pikim/bldc-hardware/design/PDF/BLDC_4-B.SilkS.pdf

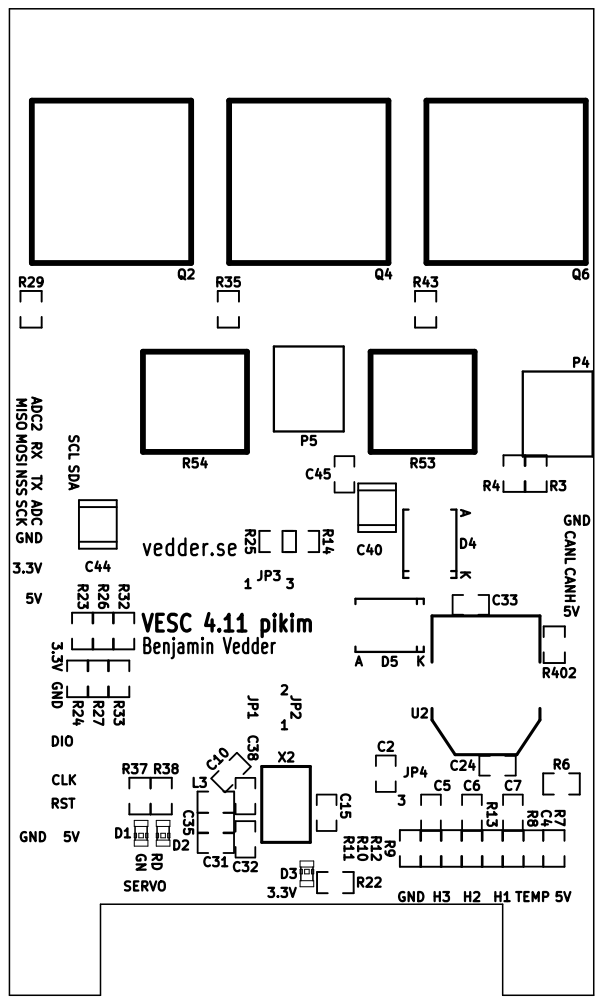
[picture p1: page 1]

5V NSS SCK MOSI MISO ADC2 SDATX SCL RX ADC vedder.seGND

5VCANH CANL GND H3 H2 H1 TEMP 5V GND GND Benjamin Vedder VESC 4.11 pikim

5V RST DIO GND CLK 3.3V
