pikim/bldc-hardware/design/PDF/BLDC_4.pdf

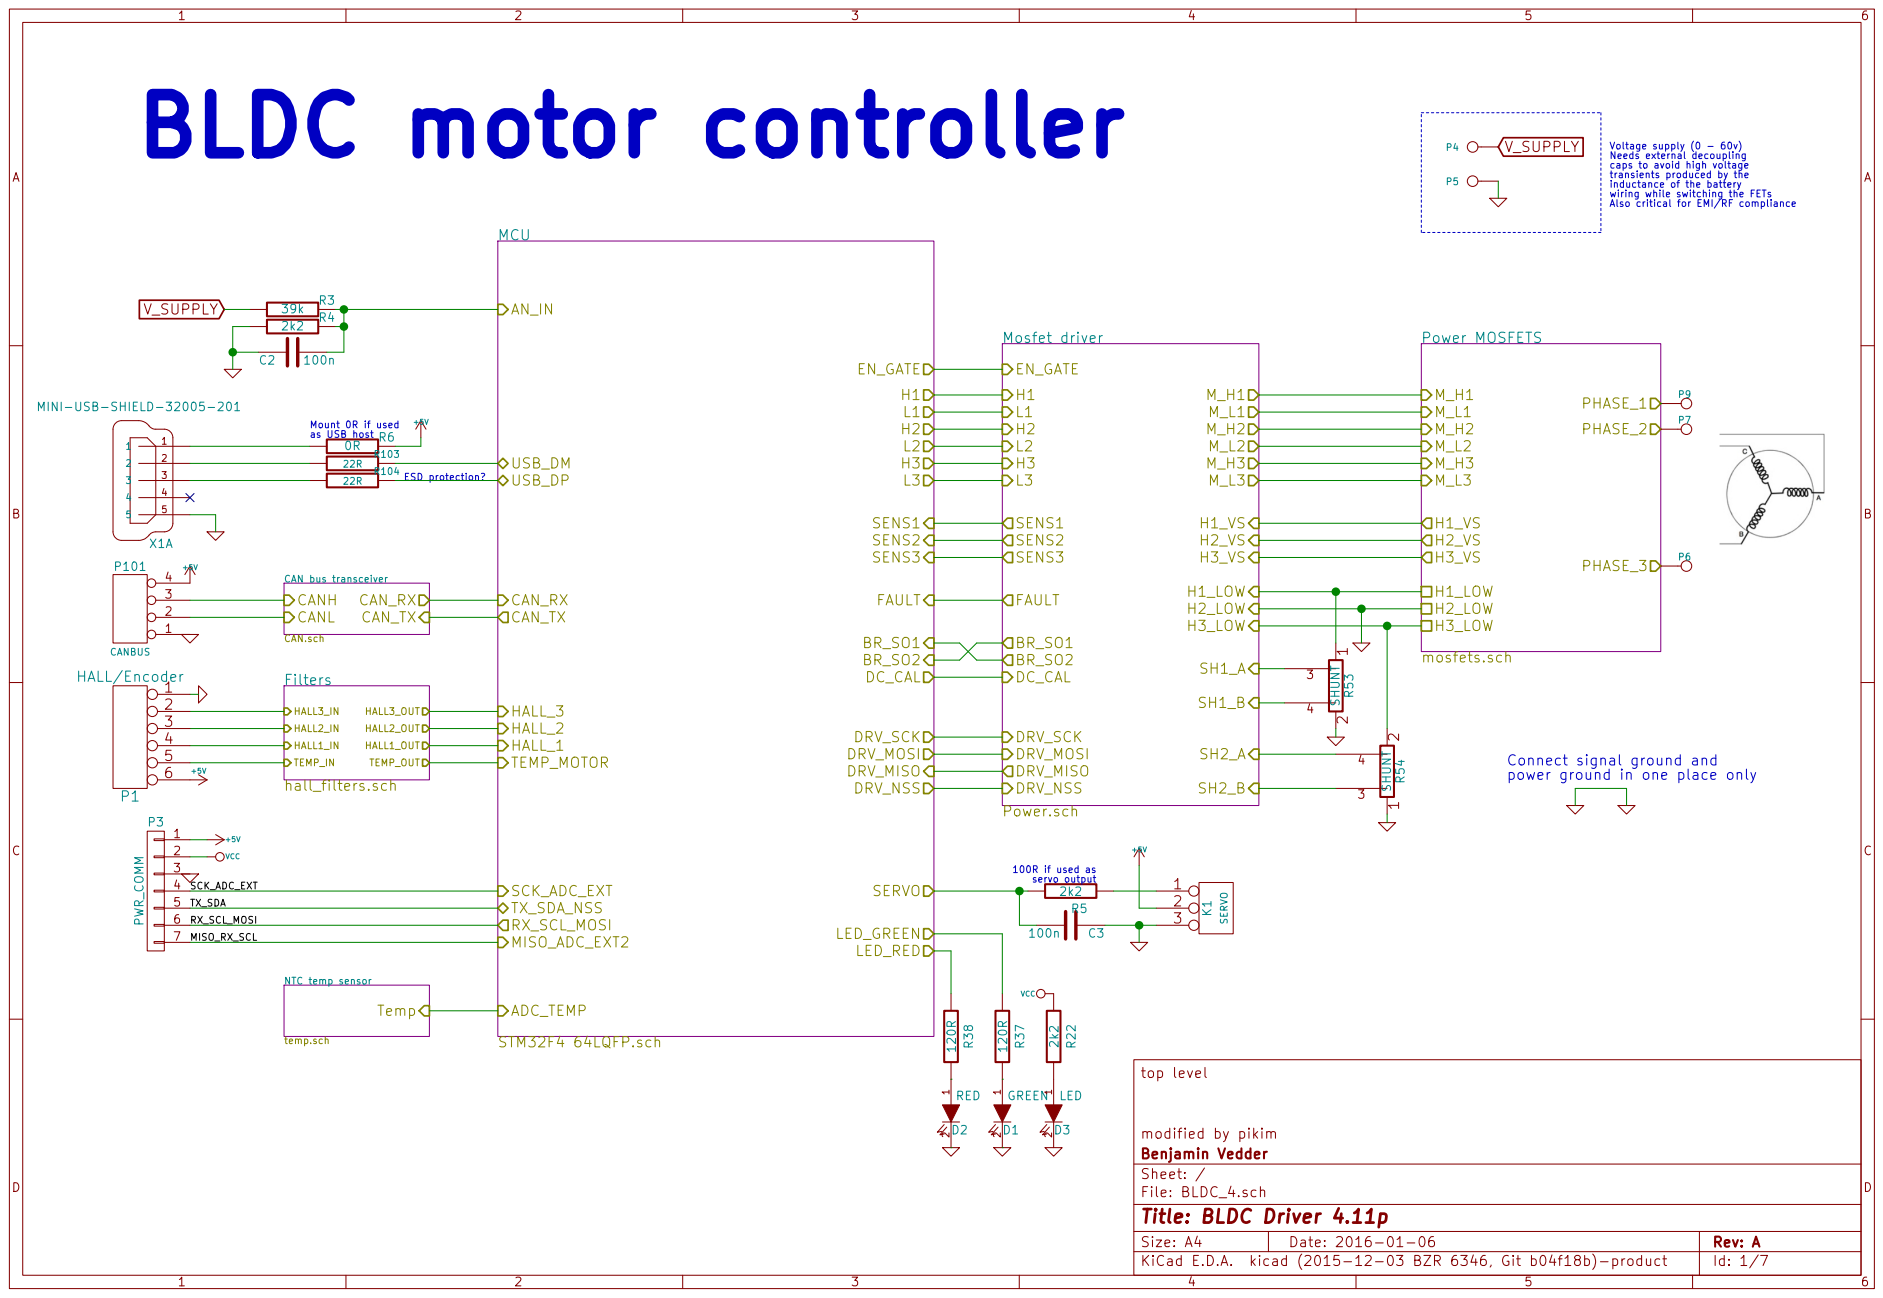
[picture p2: page 1]

Voltage supply (0 - 60v) Needs external decoupling
caps to avoid high voltage
transients produced by the

Connect signal ground and

modified by pikim
File: BLDC_4.sch Sheet: / Benjamin Vedder

Id: 1/7 Title: BLDC Driver 4.11p

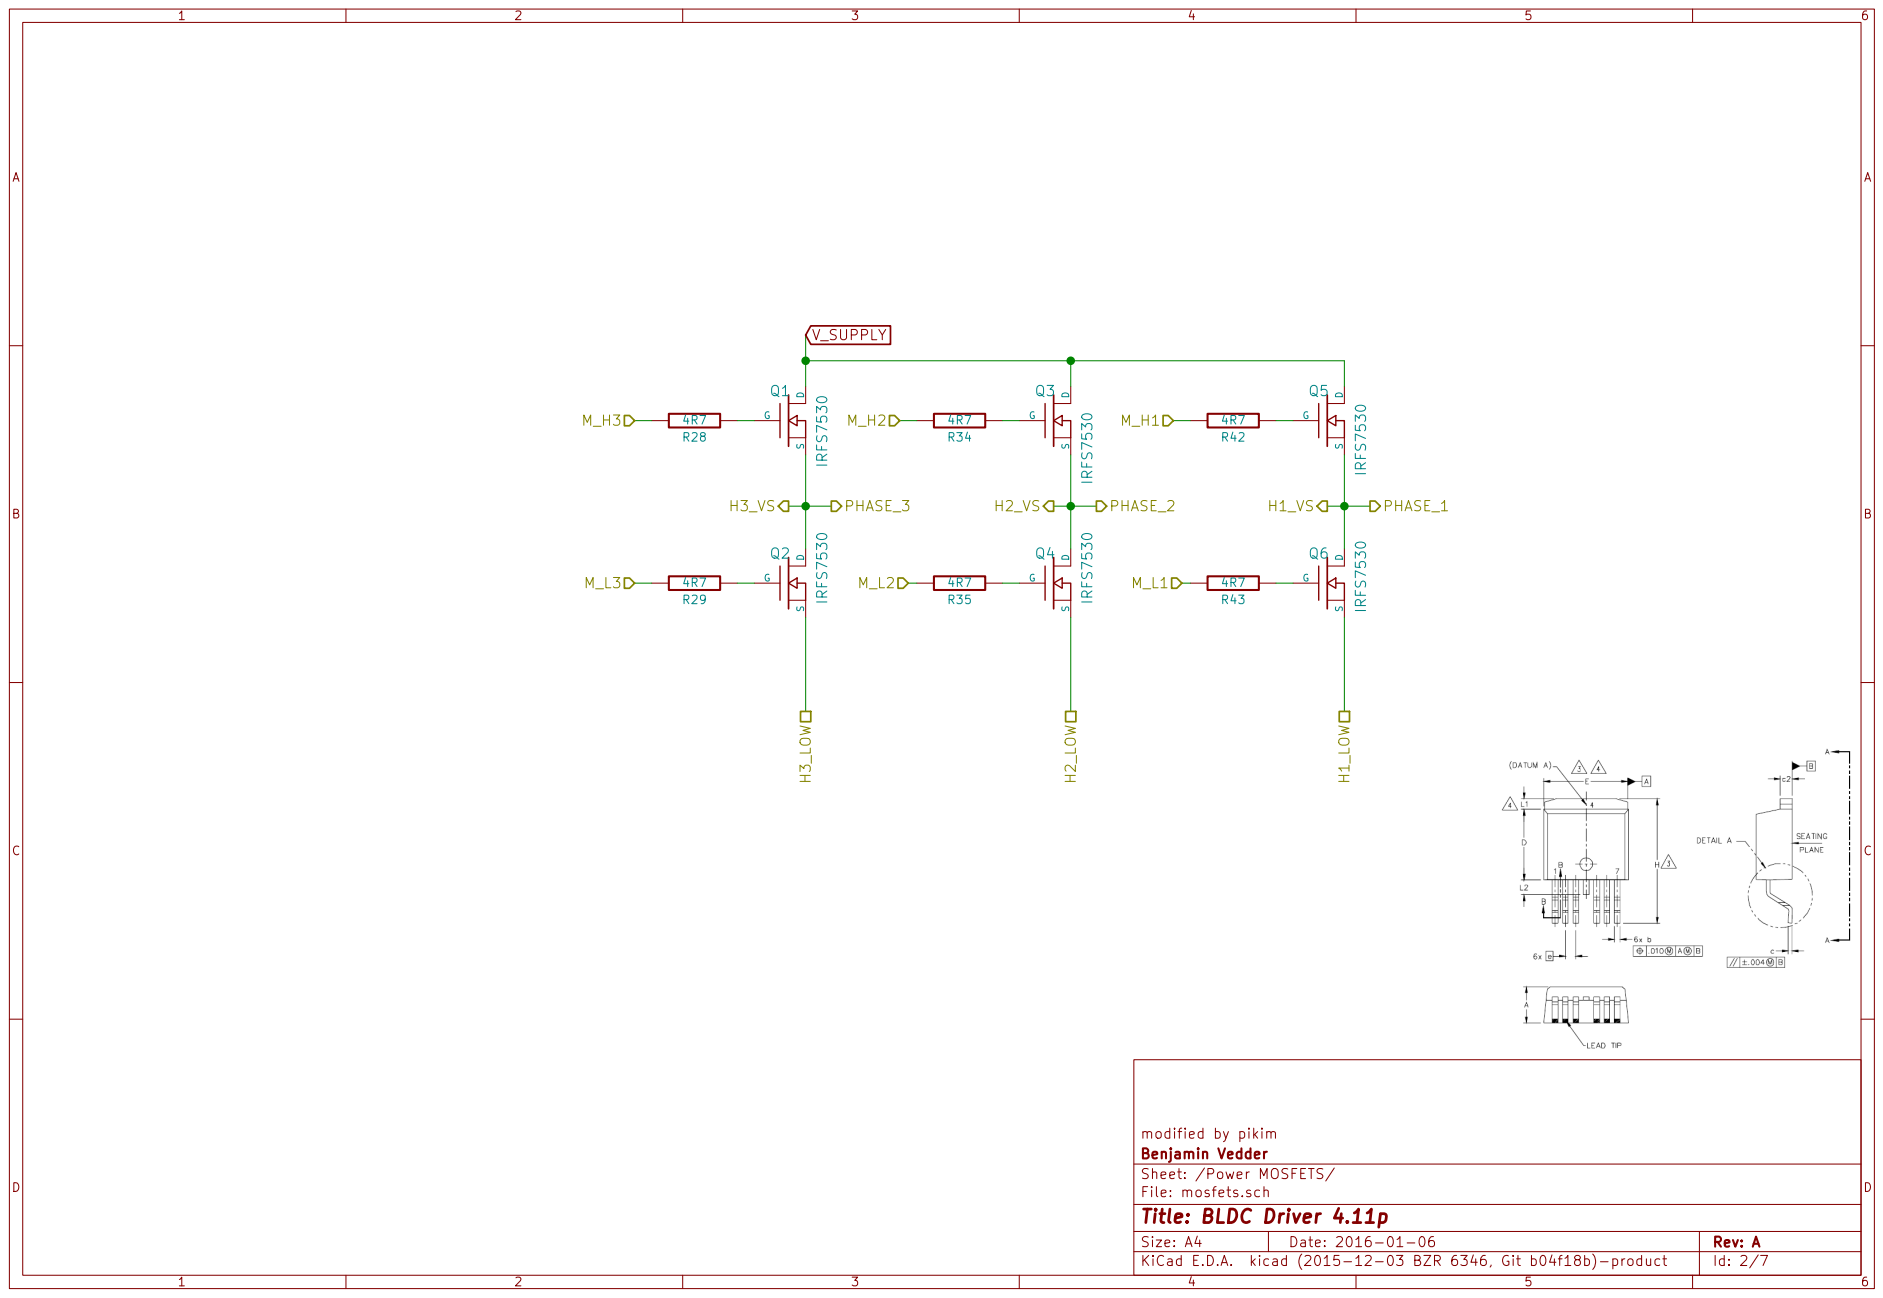
[picture p3: page 2]

modified by pikim
File: mosfets.sch Sheet: /Power MOSFETS/ Benjamin Vedder

Id: 2/7 Title: BLDC Driver 4.11p


modified by pikim R1 NTC 10k 10k R2 C41

Benjamin Vedder
Sheet: /NTC temp sensor/
File: temp.sch
Id: 3/7 Title: BLDC Driver 4.11p

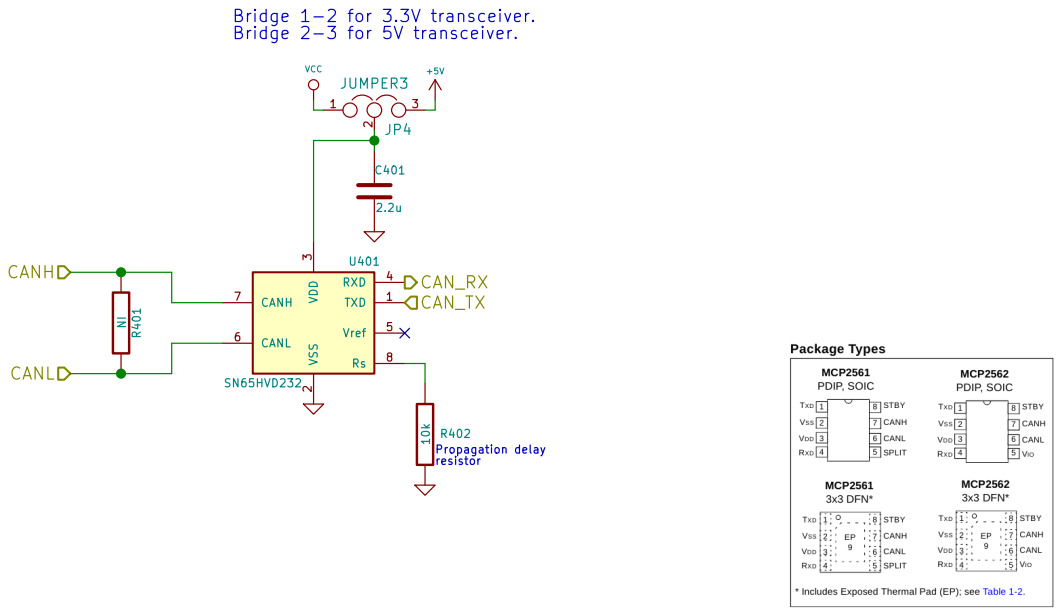
[picture p5: page 4]

3 RXD 4 Vref 5 CANL 6 CANH 7 Rs 8 U401 SN65HVD232 C401

modified by pikim
File: CAN.sch Sheet: /CAN bus transceiver/ Benjamin Vedder

Id: 4/7 Title: BLDC Driver 4.11p

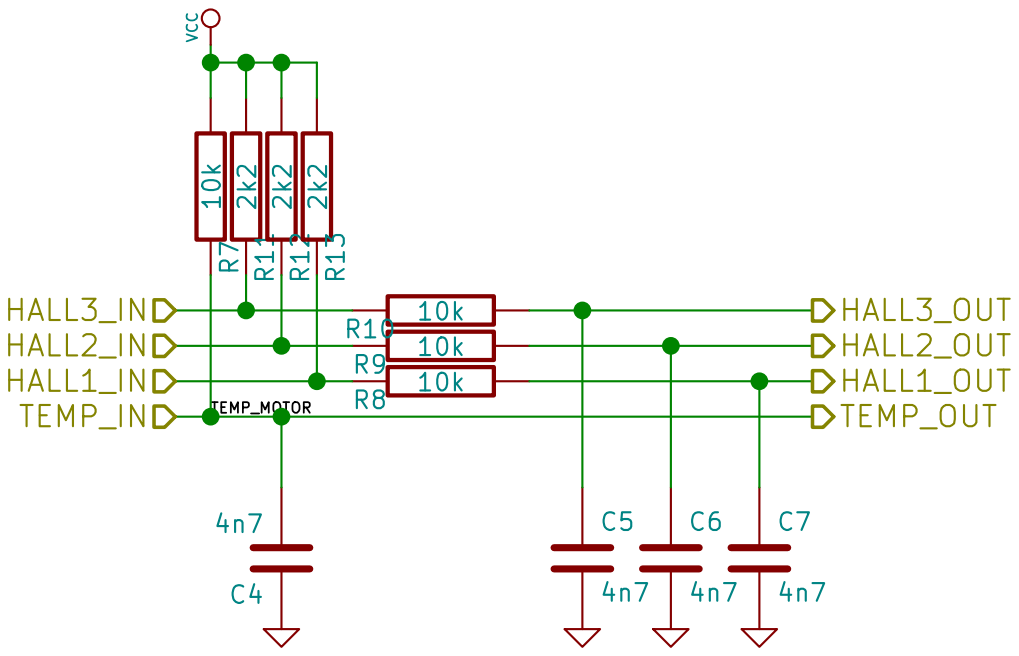
[picture p6: page 5]

File: hall_filters.sch Sheet: /Filters/ Benjamin Vedder

Id: 5/7 Title: BLDC Driver 4.11p

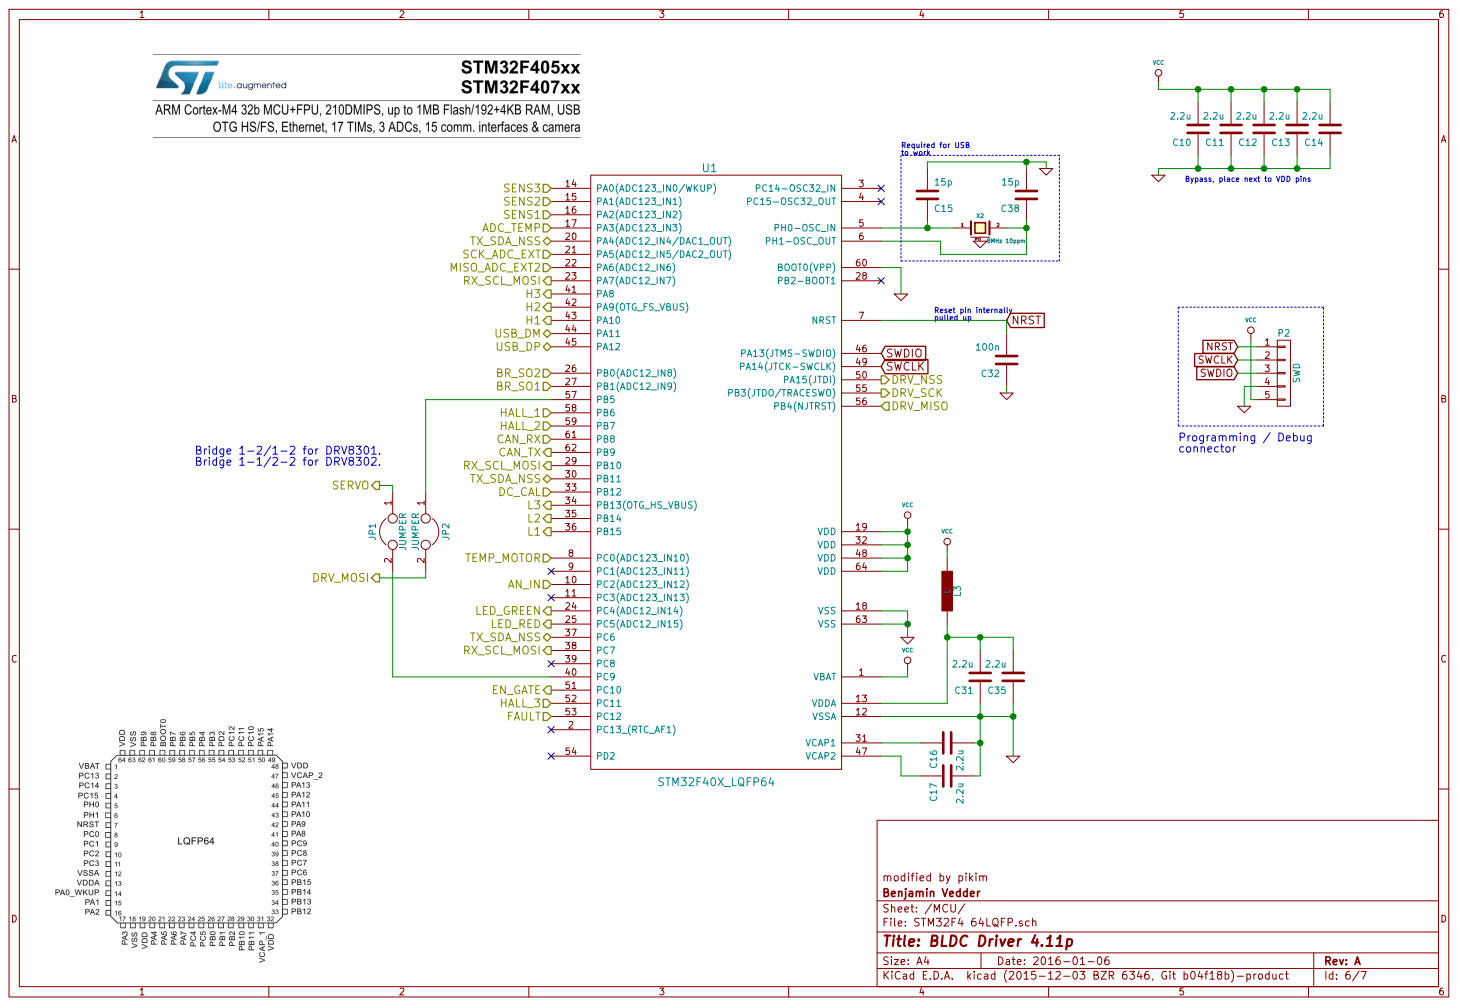
[picture p7: page 6]

modified by pikim
File: STM32F4 64LQFP.sch Sheet: /MCU/ Benjamin Vedder

Id: 6/7 Title: BLDC Driver 4.11p

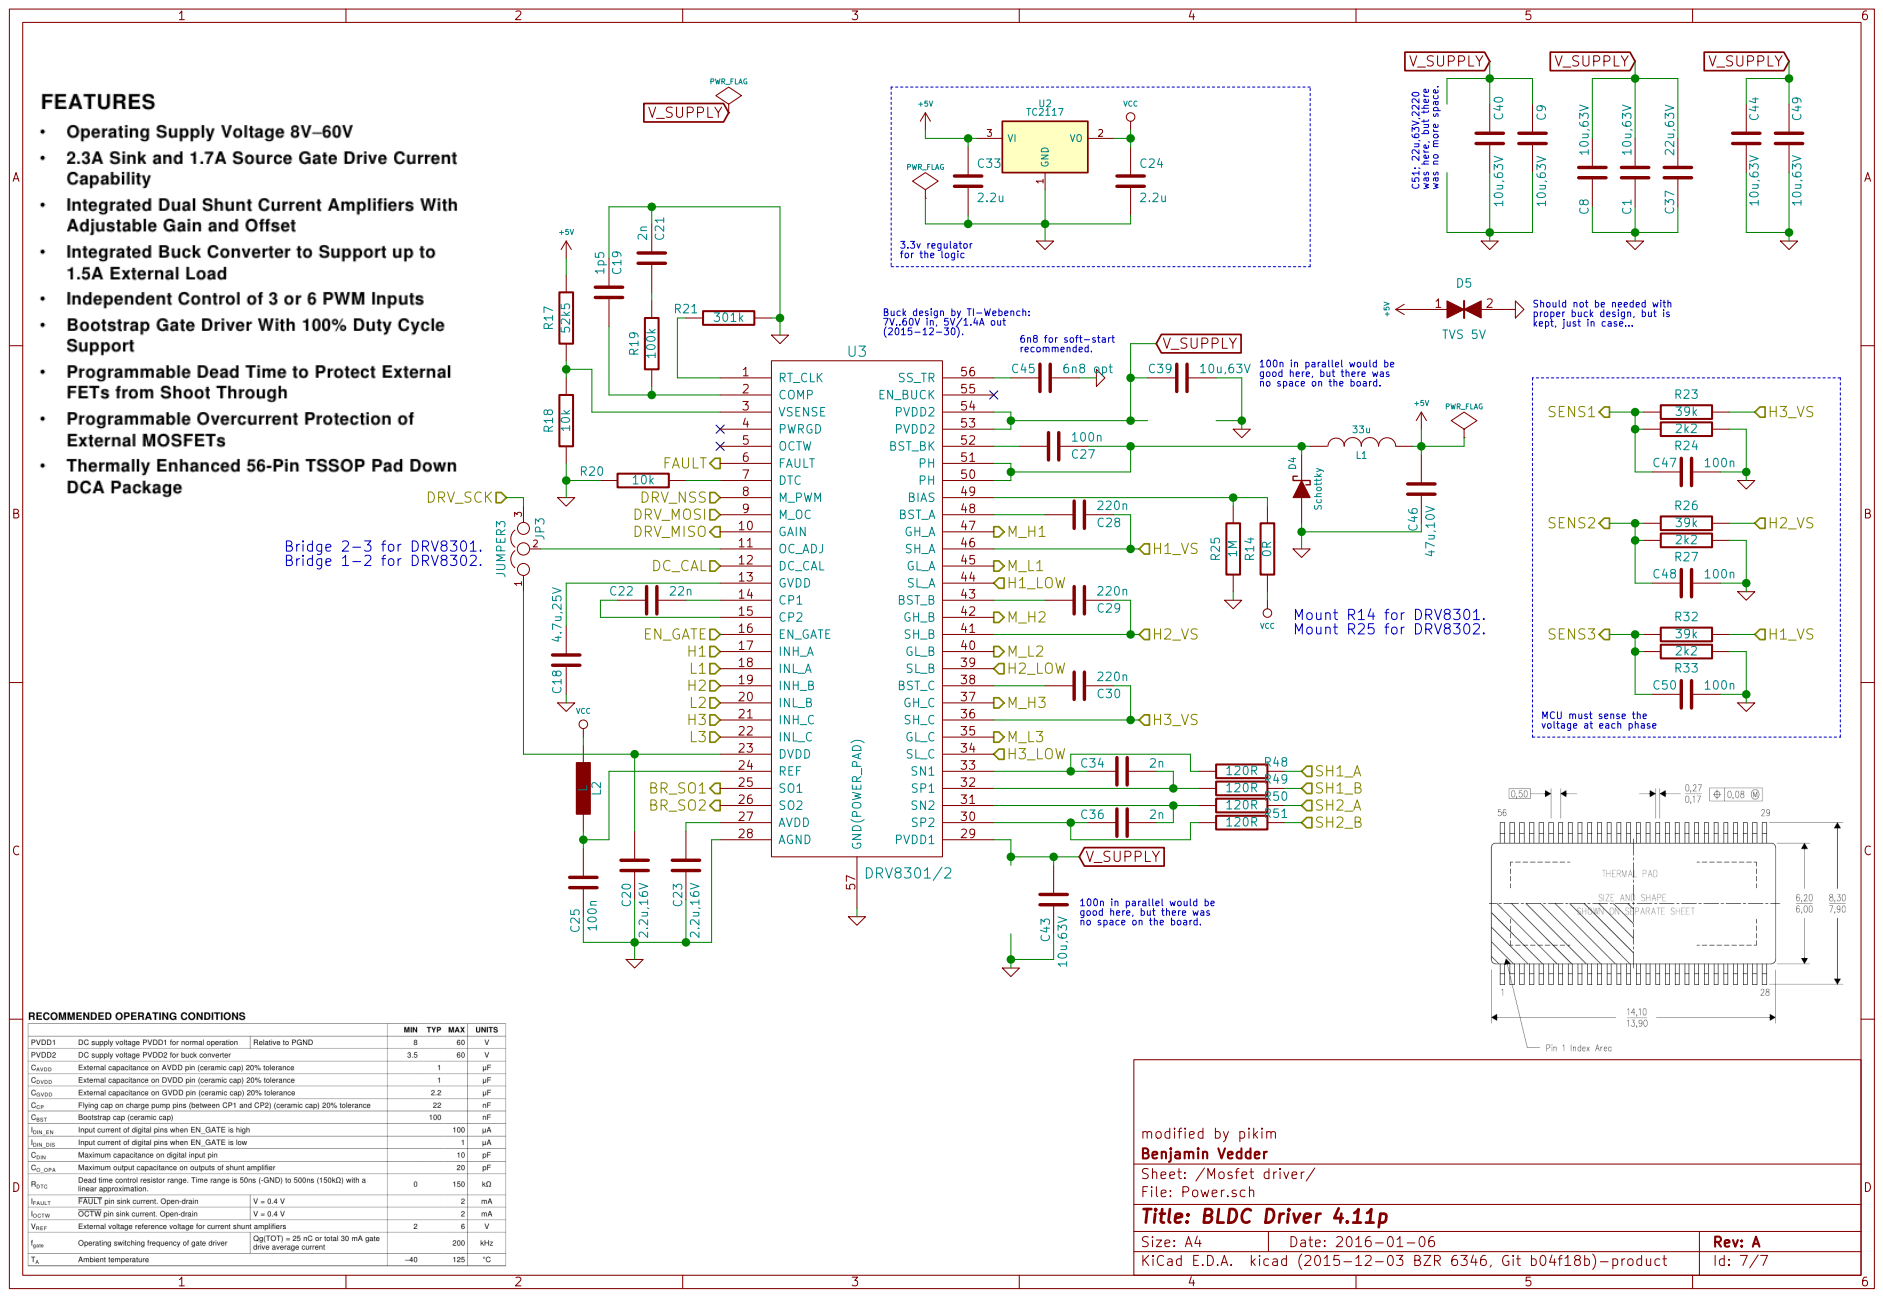
[picture p8: page 7]

proper buck design, but is

kept, just in case... Bridge 2-3 for DRV8301.

100n in parallel would be

MCU must sense the
voltage at each phase

good here, but there was no space on the board.

modified by pikim
File: Power.sch Sheet: /Mosfet driver/ Benjamin Vedder

Id: 7/7 Title: BLDC Driver 4.11p
