pikim/bldc-hardware/design/PDF/BLDC_4-F.SilkS.pdf

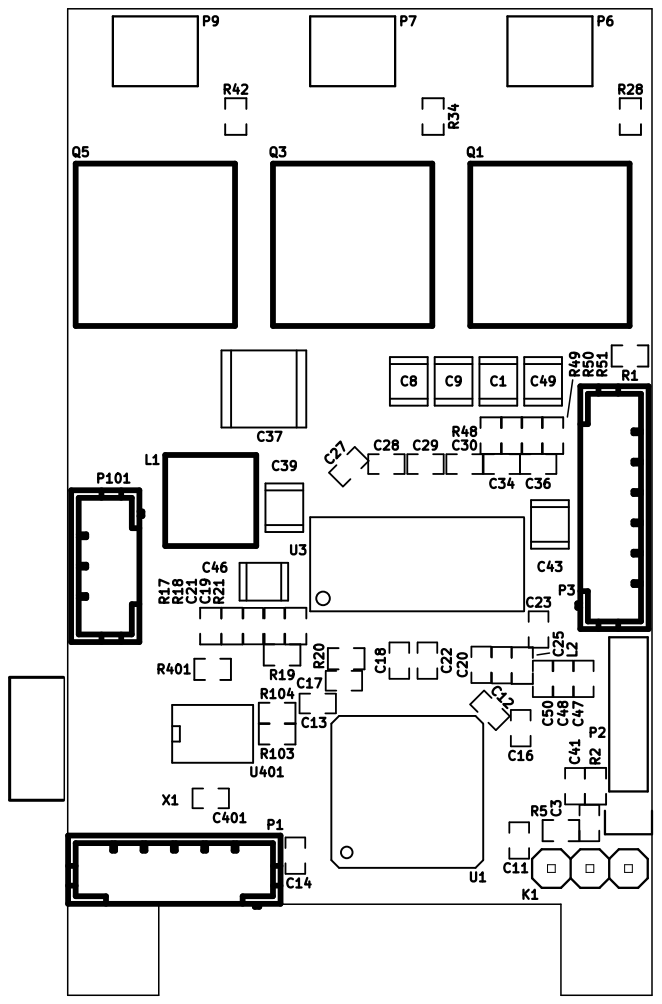
[picture p9: page 1]
