pikim/bldc-hardware/design/BLDC_4.kicad_pcb

## KiCad design design/BLDC_4.kicad_pcb (2016-01-10)

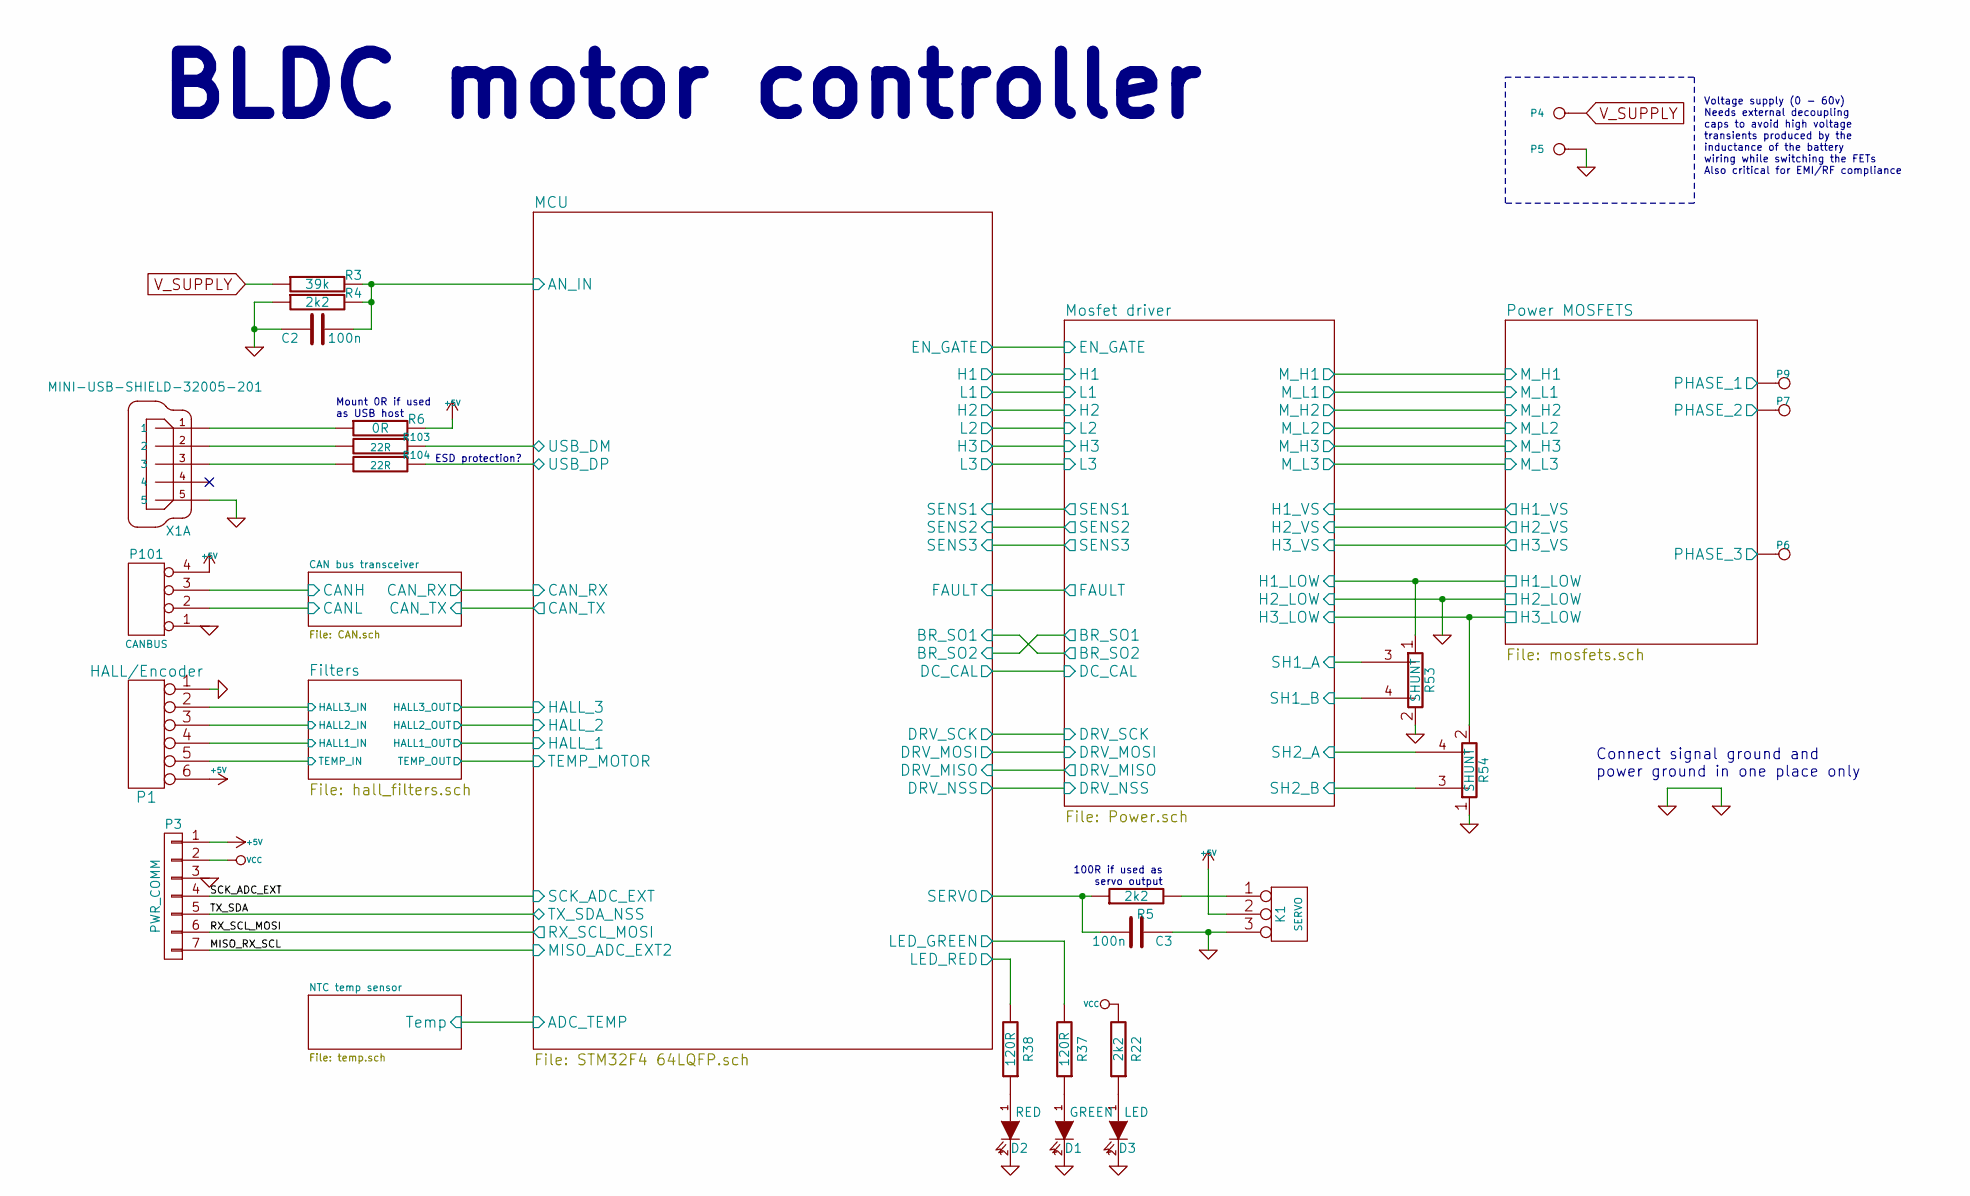
[picture p10: schematic BLDC_4.sch, BLDC Driver 4.11p]

Parts:
C2, C3: 100n; SMD-0603_c
D1: GREEN; LED-0603
D2: RED; LED-0603
D3: LED; LED-0603
K1: SERVO; pinhead-1X03
P1: HALL/Encoder; b6b-ph-kl
P3: PWR_COMM; b7b-ph-kl
P4: IN+; 1PAD_4x5mm
P5: IN-; 1PAD_4x5mm
P6: MOTOR1; 1PAD_4x5mm
P7: MOTOR2; 1PAD_4x5mm
P9: MOTOR3; 1PAD_4x5mm
P101: CANBUS; b4b-ph-kl
R3: 39k; SMD-0603_r
R4, R5, R22: 2k2; SMD-0603_r
R6: 0R; SMD-0603_r
R37, R38: 120R; SMD-0603_r
R53, R54: SHUNT; WSLP2726
R103, R104: 22R; SMD-0603_r
X1: MINI-USB-SHIELD-32005-201; USB-UX60R-MB-5ST

Connections:
+5V: K1.2 (PM), P1.6, P3.1, P101.4, R6.2; also elsewhere on the board
/CAN bus transceiver/CANH: P101.3; also elsewhere on the board
/CAN bus transceiver/CANL: P101.2; also elsewhere on the board
/Filters/HALL1_IN: P1.4; also elsewhere on the board
/Filters/HALL2_IN: P1.3; also elsewhere on the board
/Filters/HALL3_IN: P1.2; also elsewhere on the board
/Filters/TEMP_IN: P1.5; also elsewhere on the board
/MCU/AN_IN: C2.2, R3.2, R4.2; also elsewhere on the board
/MCU/LED_GREEN: R37.2; also elsewhere on the board
/MCU/LED_RED: R38.2; also elsewhere on the board
/MCU/MISO_ADC_EXT2: P3.7; also elsewhere on the board
/MCU/RX_SCL_MOSI: P3.6; also elsewhere on the board
/MCU/SCK_ADC_EXT: P3.4; also elsewhere on the board
/MCU/SERVO: C3.2, R5.1; also elsewhere on the board
/MCU/TX_SDA_NSS: P3.5; also elsewhere on the board
/MCU/USB_DM: R103.1; also elsewhere on the board
/MCU/USB_DP: R104.1; also elsewhere on the board
/Mosfet driver/H1_LOW: R53.1; also elsewhere on the board
/Mosfet driver/H1_VS: P9.1; also elsewhere on the board
/Mosfet driver/H2_VS: P7.1; also elsewhere on the board
/Mosfet driver/H3_LOW: R54.2; also elsewhere on the board
/Mosfet driver/H3_VS: P6.1; also elsewhere on the board
/Mosfet driver/SH1_A: R53.3; also elsewhere on the board
/Mosfet driver/SH1_B: R53.4; also elsewhere on the board
/Mosfet driver/SH2_A: R54.4; also elsewhere on the board
/Mosfet driver/SH2_B: R54.3; also elsewhere on the board
GND: C2.1, C3.1, D1.2 (K), D2.2 (K), D3.2 (K), K1.3, P1.1, P3.3, P5.1, P101.1, R4.1, R53.2, R54.1, X1.5; also elsewhere on the board
unnamed: D1.1 (A), R37.1
unnamed: D2.1 (A), R38.1
unnamed: D3.1 (A), R22.1
unnamed: K1.1, R5.2
unnamed: R6.1, X1.1
unnamed: R103.2, X1.2
unnamed: R104.2, X1.3
VCC: P3.2, R22.2; also elsewhere on the board
V_SUPPLY: P4.1, R3.1; also elsewhere on the board

Notes on the sheet:
100R if used as servo output
Mount 0R if used as USB host
ESD protection?
BLDC motor controller
Voltage supply (0 - 60v) Needs external decoupling caps to avoid high voltage transients produced by the inductance of the battery wiring while switching the FETs Also critical for EMI/RF compliance
Connect signal ground and power ground in one place only

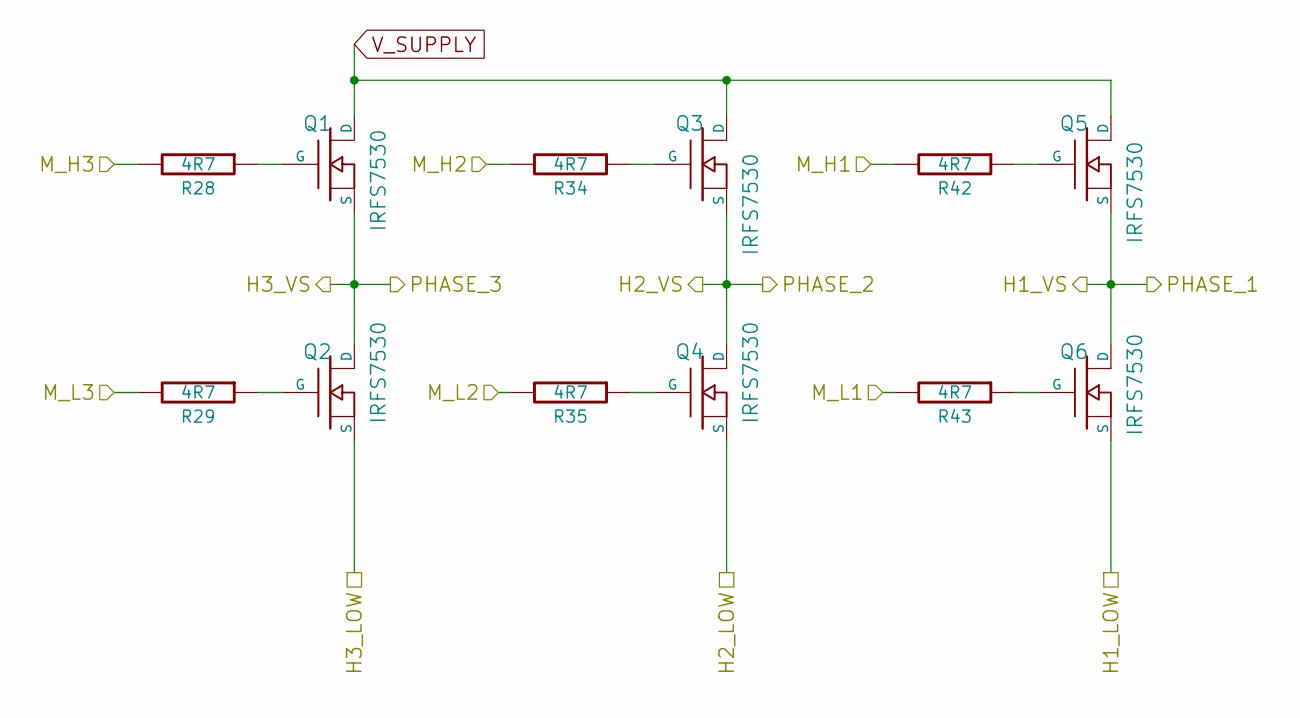
[picture p11: schematic mosfets.sch, BLDC Driver 4.11p]

Parts:
Q1, Q2, Q3, Q4, Q5, Q6: IRFS7530; D2PAK-7-GDS
R28, R29, R34, R35, R42, R43: 4R7; SMD-0603_r

Connections:
/Mosfet driver/H1_LOW: Q6.S; also elsewhere on the board
/Mosfet driver/H1_VS: Q5.S, Q6.D; also elsewhere on the board
/Mosfet driver/H2_VS: Q3.S, Q4.D; also elsewhere on the board
/Mosfet driver/H3_LOW: Q2.S; also elsewhere on the board
/Mosfet driver/H3_VS: Q1.S, Q2.D; also elsewhere on the board
/Mosfet driver/M_H1: R42.2; also elsewhere on the board
/Mosfet driver/M_H2: R34.2; also elsewhere on the board
/Mosfet driver/M_H3: R28.2; also elsewhere on the board
/Mosfet driver/M_L1: R43.2; also elsewhere on the board
/Mosfet driver/M_L2: R35.2; also elsewhere on the board
/Mosfet driver/M_L3: R29.2; also elsewhere on the board
GND: Q4.S; also elsewhere on the board
unnamed: Q1.G, R28.1
unnamed: Q2.G, R29.1
unnamed: Q3.G, R34.1
unnamed: Q4.G, R35.1
unnamed: Q5.G, R42.1
unnamed: Q6.G, R43.1
V_SUPPLY: Q1.D, Q3.D, Q5.D; also elsewhere on the board


Parts:
C41: 2.2u; SMD-0603_c; Part# GRM188R61C225KAAD or GRM188C81A225KAAD
R1: NTC 10k; SMD-0603_r
R2: 10k; SMD-0603_r

Connections:
/MCU/ADC_TEMP: C41.1, R1.2, R2.1; also elsewhere on the board
GND: C41.2, R2.2; also elsewhere on the board
VCC: R1.1; also elsewhere on the board

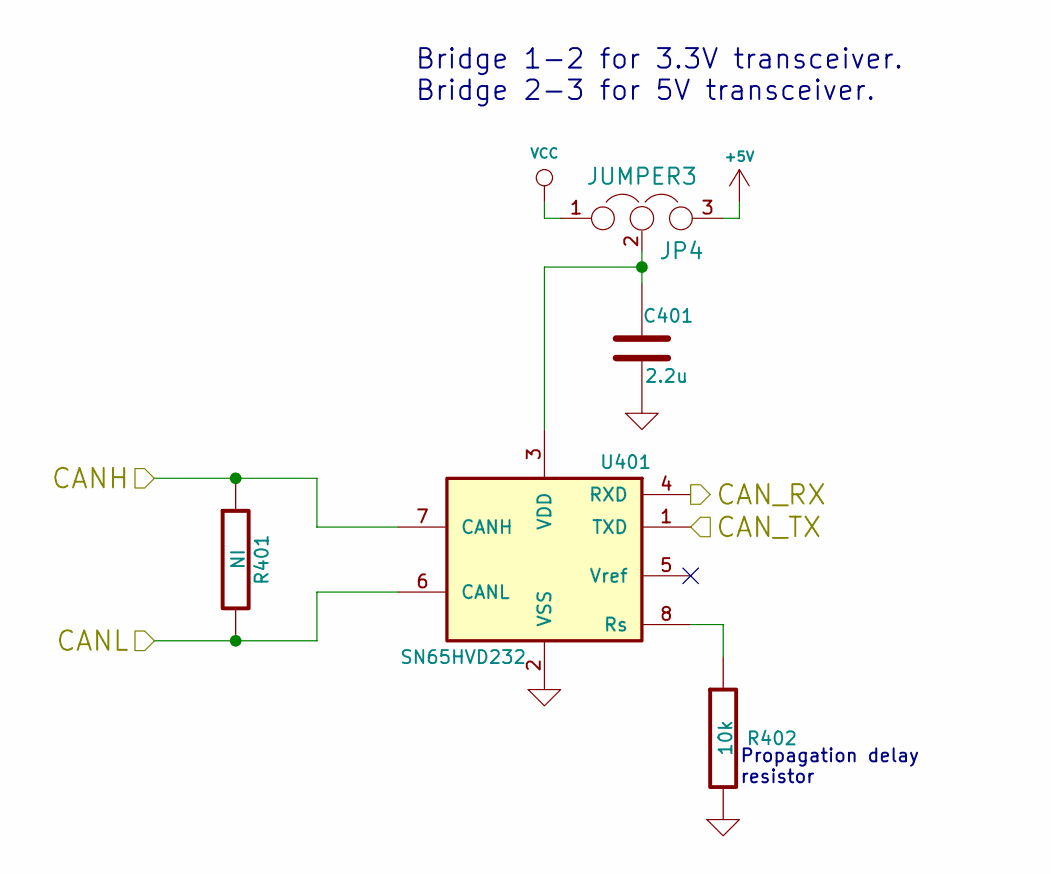
[picture p13: schematic CAN.sch, BLDC Driver 4.11p]

Parts:
C401: 2.2u; SMD-0603_c; Part# GRM188R61C225KAAD or GRM188C81A225KAAD
JP4: JUMPER3; S_JUMPER_3
R401: NI; SMD-0603_r
R402: 10k; SMD-0603_r
U401: SN65HVD232; SOIC-8-W

Connections:
+5V: JP4.3; also elsewhere on the board
/CAN bus transceiver/CANH: R401.1, U401.7 (CANH); also elsewhere on the board
/CAN bus transceiver/CANL: R401.2, U401.6 (CANL); also elsewhere on the board
/CAN bus transceiver/CAN_RX: U401.4 (RXD); also elsewhere on the board
/CAN bus transceiver/CAN_TX: U401.1 (TXD); also elsewhere on the board
GND: C401.2, R402.2, U401.2 (VSS); also elsewhere on the board
unnamed: C401.1, JP4.2, U401.3 (VDD)
unnamed: R402.1, U401.8 (Rs)
VCC: JP4.1; also elsewhere on the board

Notes on the sheet:
Propagation delay resistor
Bridge 1-2 for 3.3V transceiver. Bridge 2-3 for 5V transceiver.

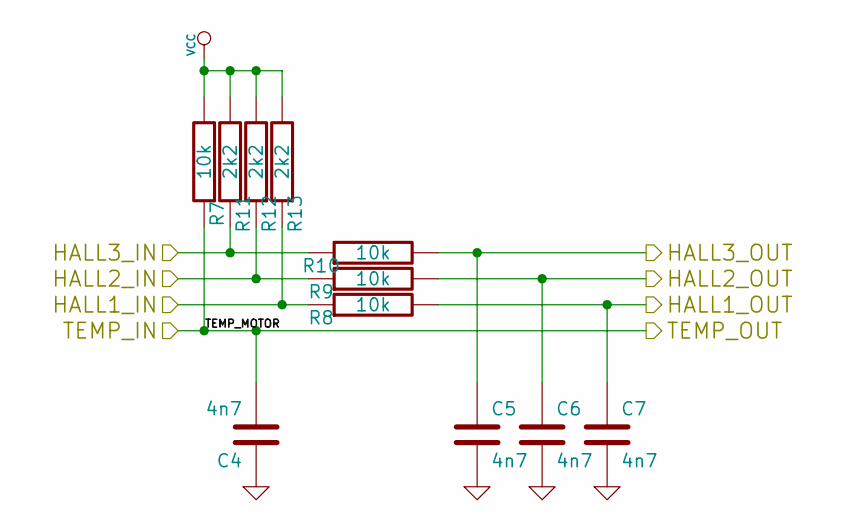
[picture p14: schematic hall_filters.sch, BLDC Driver 4.11p]

Parts:
C4, C5, C6, C7: 4n7; SMD-0603_c
R7, R8, R9, R10: 10k; SMD-0603_r
R11, R12, R13: 2k2; SMD-0603_r

Connections:
/Filters/HALL1_IN: R8.1, R13.1; also elsewhere on the board
/Filters/HALL1_OUT: C7.1, R8.2; also elsewhere on the board
/Filters/HALL2_IN: R9.1, R12.1; also elsewhere on the board
/Filters/HALL2_OUT: C6.1, R9.2; also elsewhere on the board
/Filters/HALL3_IN: R10.1, R11.1; also elsewhere on the board
/Filters/HALL3_OUT: C5.1, R10.2; also elsewhere on the board
/Filters/TEMP_IN: C4.2, R7.1; also elsewhere on the board
GND: C4.1, C5.2, C6.2, C7.2; also elsewhere on the board
VCC: R7.2, R11.2, R12.2, R13.2; also elsewhere on the board

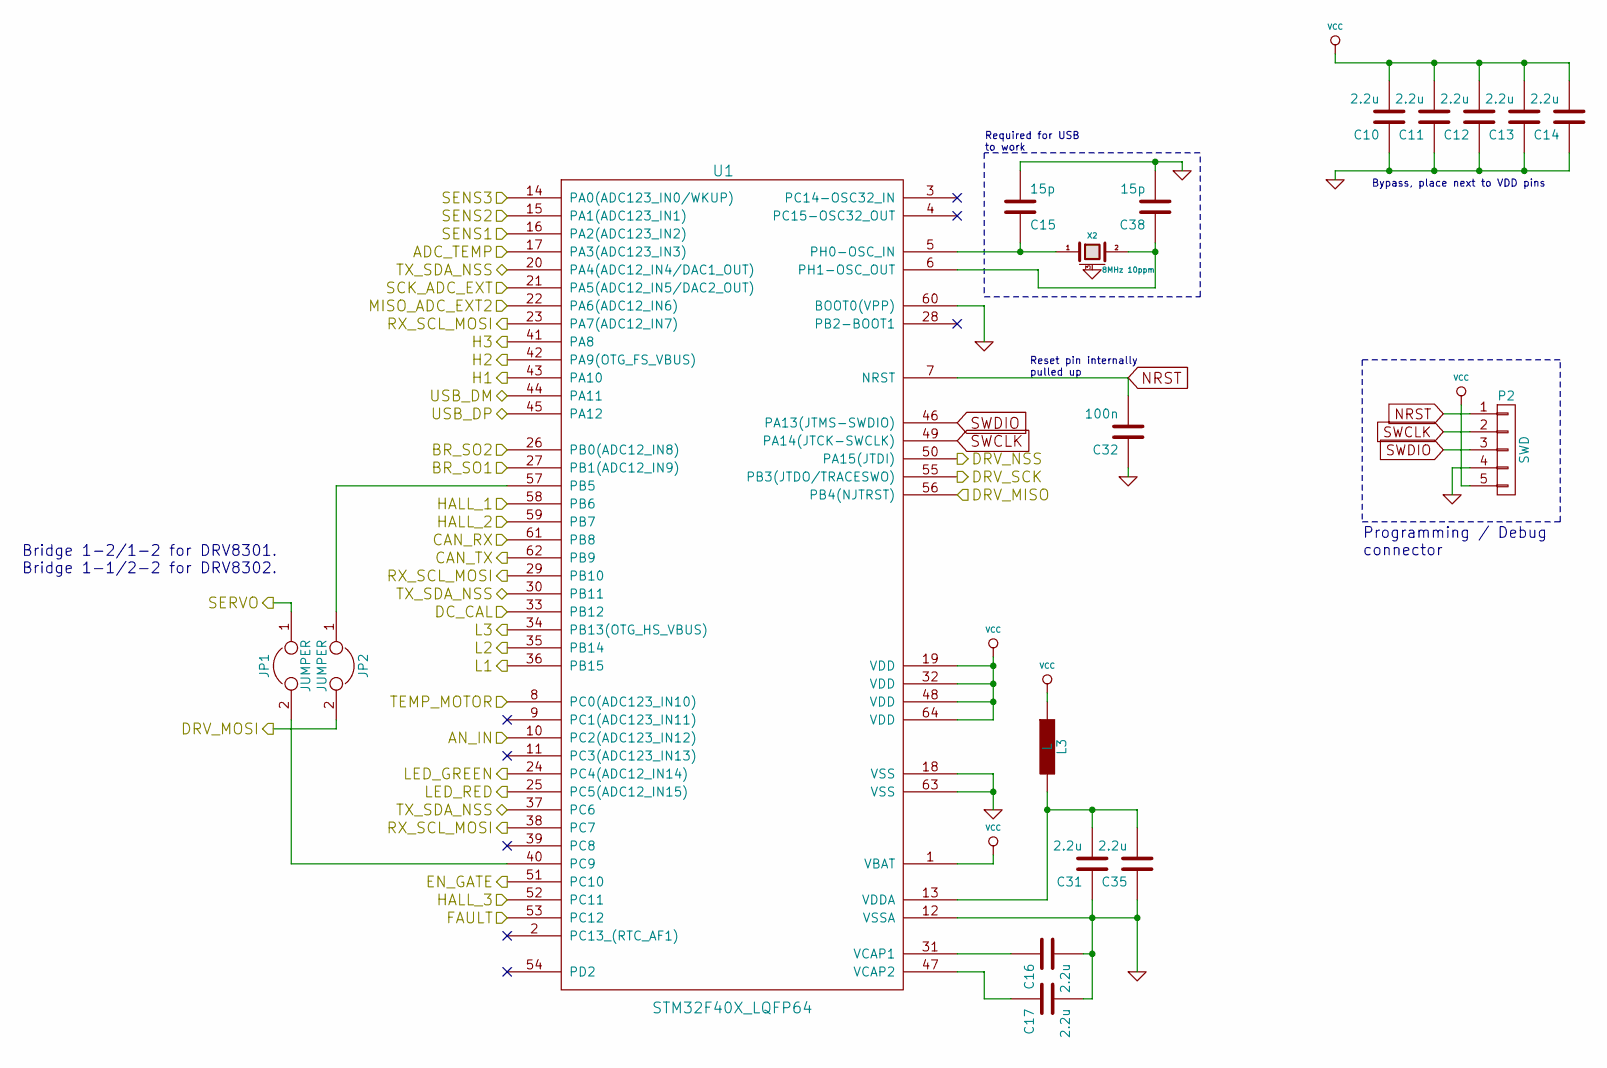
[picture p15: schematic STM32F4 64LQFP.sch, BLDC Driver 4.11p]

Parts:
C10, C11, C12, C13, C14, C16, C17, C31, C35: 2.2u; SMD-0603_c; Part# GRM188R61C225KAAD or GRM188C81A225KAAD
C15, C38: 15p; SMD-0603_c
C32: 100n; SMD-0603_c
JP1, JP2: JUMPER; S_JUMPER_2
L3: L; SMD-0603_r
P2: SWD; Pin_Header_Straight_1x05
U1: STM32F40X_LQFP64; lqfp64_pad_mod
X2: 8MHz 10ppm; Crystal_5x3mm; Part# ABM3B-8.0-10-1UT

Connections:
/CAN bus transceiver/CAN_RX: U1.61 (PB8); also elsewhere on the board
/CAN bus transceiver/CAN_TX: U1.62 (PB9); also elsewhere on the board
/Filters/HALL1_OUT: U1.58 (PB6); also elsewhere on the board
/Filters/HALL2_OUT: U1.59 (PB7); also elsewhere on the board
/Filters/HALL3_OUT: U1.52 (PC11); also elsewhere on the board
/Filters/TEMP_IN: U1.8 (PC0(ADC123_IN10)); also elsewhere on the board
/MCU/ADC_TEMP: U1.17 (PA3(ADC123_IN3)); also elsewhere on the board
/MCU/AN_IN: U1.10 (PC2(ADC123_IN12)); also elsewhere on the board
/MCU/BR_SO1: U1.27 (PB1(ADC12_IN9)); also elsewhere on the board
/MCU/DC_CAL: U1.33 (PB12); also elsewhere on the board
/MCU/DRV_MISO: U1.56 (PB4(NJTRST)); also elsewhere on the board
/MCU/DRV_MOSI: JP2.2; also elsewhere on the board
/MCU/DRV_NSS: U1.50 (PA15(JTDI)); also elsewhere on the board
/MCU/DRV_SCK: U1.55 (PB3(JTDO/TRACESWO)); also elsewhere on the board
/MCU/EN_GATE: U1.51 (PC10); also elsewhere on the board
/MCU/FAULT: U1.53 (PC12); also elsewhere on the board
/MCU/H1: U1.43 (PA10); also elsewhere on the board
/MCU/H2: U1.42 (PA9(OTG_FS_VBUS)); also elsewhere on the board
/MCU/H3: U1.41 (PA8); also elsewhere on the board
/MCU/L1: U1.36 (PB15); also elsewhere on the board
/MCU/L2: U1.35 (PB14); also elsewhere on the board
/MCU/L3: U1.34 (PB13(OTG_HS_VBUS)); also elsewhere on the board
/MCU/LED_GREEN: U1.24 (PC4(ADC12_IN14)); also elsewhere on the board
/MCU/LED_RED: U1.25 (PC5(ADC12_IN15)); also elsewhere on the board
/MCU/MISO_ADC_EXT2: U1.22 (PA6(ADC12_IN6)); also elsewhere on the board
/MCU/RX_SCL_MOSI: U1.23 (PA7(ADC12_IN7)), U1.29 (PB10), U1.38 (PC7); also elsewhere on the board
/MCU/SCK_ADC_EXT: U1.21 (PA5(ADC12_IN5/DAC2_OUT)); also elsewhere on the board
/MCU/SENS1: U1.16 (PA2(ADC123_IN2)); also elsewhere on the board
/MCU/SENS2: U1.15 (PA1(ADC123_IN1)); also elsewhere on the board
/MCU/SENS3: U1.14 (PA0(ADC123_IN0/WKUP)); also elsewhere on the board
/MCU/SERVO: JP1.1; also elsewhere on the board
/MCU/TX_SDA_NSS: U1.20 (PA4(ADC12_IN4/DAC1_OUT)), U1.30 (PB11), U1.37 (PC6); also elsewhere on the board
/MCU/USB_DM: U1.44 (PA11); also elsewhere on the board
/MCU/USB_DP: U1.45 (PA12); also elsewhere on the board
/Mosfet driver/BR_SO1: U1.26 (PB0(ADC12_IN8)); also elsewhere on the board
GND: C10.1, C11.1, C12.1, C13.1, C14.1, C15.2, C16.2, C17.2, C31.1, C32.1, C35.1, C38.2, P2.4, U1.12 (VSSA), U1.18 (VSS), U1.60 (BOOT0(VPP)), U1.63 (VSS), X2.3 (case); also elsewhere on the board
NRST: C32.2, P2.1, U1.7 (NRST)
unnamed: C15.1, U1.5 (PH0-OSC_IN), X2.1
unnamed: C16.1, U1.31 (VCAP1)
unnamed: C17.1, U1.47 (VCAP2)
unnamed: C31.2, C35.2, L3.2, U1.13 (VDDA)
unnamed: C38.1, U1.6 (PH1-OSC_OUT), X2.2
unnamed: JP1.2, U1.40 (PC9)
unnamed: JP2.1, U1.57 (PB5)
SWCLK: P2.2, U1.49 (PA14(JTCK-SWCLK))
SWDIO: P2.3, U1.46 (PA13(JTMS-SWDIO))
VCC: C10.2, C11.2, C12.2, C13.2, C14.2, L3.1, P2.5, U1.1 (VBAT), U1.19 (VDD), U1.32 (VDD), U1.48 (VDD), U1.64 (VDD); also elsewhere on the board

Notes on the sheet:
Programming / Debug connector
Reset pin internally pulled up
Required for USB to work
Bypass, place next to VDD pins
Bridge 1-2/1-2 for DRV8301. Bridge 1-1/2-2 for DRV8302.

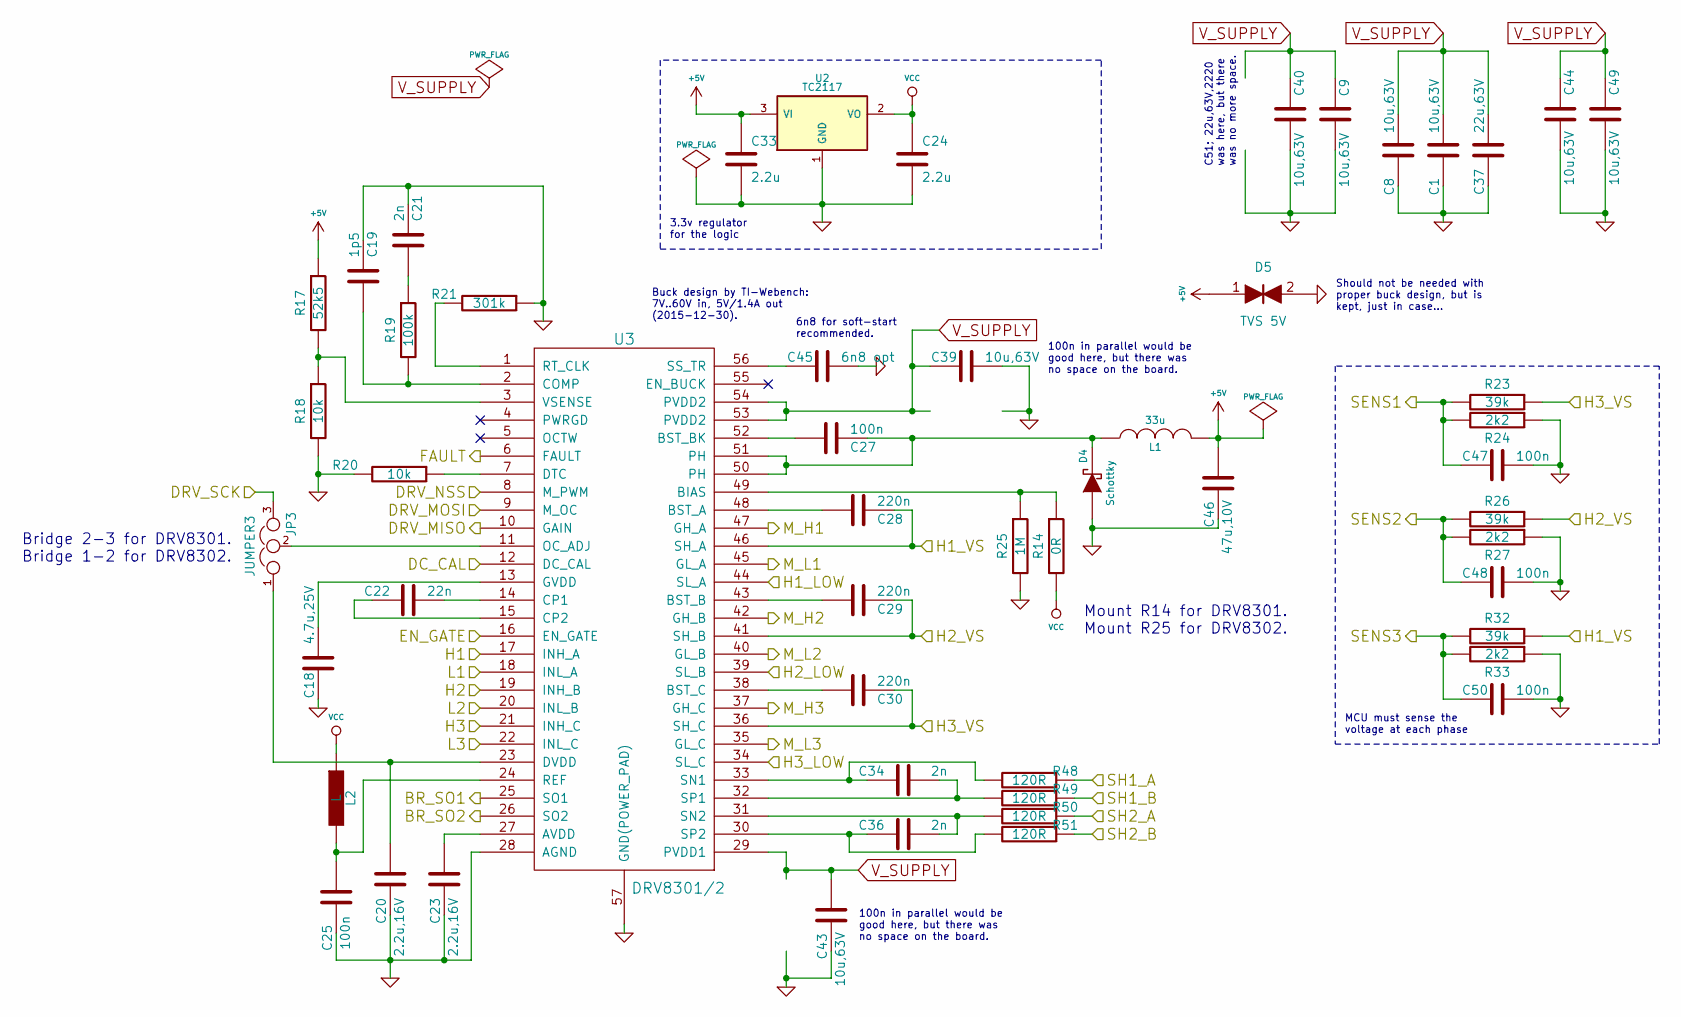
[picture p16: schematic Power.sch, BLDC Driver 4.11p]

Parts:
C1, C8, C9, C39, C40, C43, C44, C49: 10u,63V; c_1210; Part# GRM32ER71J106KA12
C18: 4.7u,25V; SMD-0603_c; Part# GRM188R61E475KE15
C19: 1p5; SMD-0603_c
C20, C23: 2.2u,16V; SMD-0603_c; Part# GRM188R61C225KAAD
C21, C34, C36: 2n; SMD-0603_c
C22: 22n; SMD-0603_c
C24, C33: 2.2u; SMD-0603_c; Part# GRM188R61C225KAAD or GRM188C81A225KAAD
C25, C27, C47, C48, C50: 100n; SMD-0603_c
C28, C29, C30: 220n; SMD-0603_c
C37: 22u,63V; c_2220; Part# KRM55WR71J226MH01
C45: 6n8 opt; SMD-0603_c
C46: 47u,10V; c_1210; Part# GRM32ER61A476KE20
D4: Schottky; SMA_Standard
D5: TVS 5V; SMA_Standard
JP3: JUMPER3; S_JUMPER_3
L1: 33u; inductor_smd_6x6mm
L2: L; SMD-0603_r
R14: 0R; SMD-0603_r
R17: 52k5; SMD-0603_r
R18, R20: 10k; SMD-0603_r
R19: 100k; SMD-0603_r
R21: 301k; SMD-0603_r
R23, R26, R32: 39k; SMD-0603_r
R24, R27, R33: 2k2; SMD-0603_r
R25: 1M; SMD-0603_r
R48, R49, R50, R51: 120R; SMD-0603_r
U2: TC2117; SOT-223
U3: DRV8301/2; TSSOP-56-PP

Connections:
+5V: C33.1, C46.1, D5.1, L1.2, R17.1, U2.3 (VI); also elsewhere on the board
/MCU/BR_SO1: U3.26 (SO2); also elsewhere on the board
/MCU/DC_CAL: U3.12 (DC_CAL); also elsewhere on the board
/MCU/DRV_MISO: U3.10 (GAIN); also elsewhere on the board
/MCU/DRV_MOSI: U3.9 (M_OC); also elsewhere on the board
/MCU/DRV_NSS: U3.8 (M_PWM); also elsewhere on the board
/MCU/DRV_SCK: JP3.3; also elsewhere on the board
/MCU/EN_GATE: U3.16 (EN_GATE); also elsewhere on the board
/MCU/FAULT: U3.6 (FAULT); also elsewhere on the board
/MCU/H1: U3.17 (INH_A); also elsewhere on the board
/MCU/H2: U3.19 (INH_B); also elsewhere on the board
/MCU/H3: U3.21 (INH_C); also elsewhere on the board
/MCU/L1: U3.18 (INL_A); also elsewhere on the board
/MCU/L2: U3.20 (INL_B); also elsewhere on the board
/MCU/L3: U3.22 (INL_C); also elsewhere on the board
/MCU/SENS1: C47.2, R23.2, R24.2; also elsewhere on the board
/MCU/SENS2: C48.2, R26.2, R27.2; also elsewhere on the board
/MCU/SENS3: C50.2, R32.2, R33.2; also elsewhere on the board
/Mosfet driver/BR_SO1: U3.25 (SO1); also elsewhere on the board
/Mosfet driver/H1_LOW: U3.44 (SL_A); also elsewhere on the board
/Mosfet driver/H1_VS: C28.1, R32.1, U3.46 (SH_A); also elsewhere on the board
/Mosfet driver/H2_VS: C29.1, R26.1, U3.41 (SH_B); also elsewhere on the board
/Mosfet driver/H3_LOW: U3.34 (SL_C); also elsewhere on the board
/Mosfet driver/H3_VS: C30.1, R23.1, U3.36 (SH_C); also elsewhere on the board
/Mosfet driver/M_H1: U3.47 (GH_A); also elsewhere on the board
/Mosfet driver/M_H2: U3.42 (GH_B); also elsewhere on the board
/Mosfet driver/M_H3: U3.37 (GH_C); also elsewhere on the board
/Mosfet driver/M_L1: U3.45 (GL_A); also elsewhere on the board
/Mosfet driver/M_L2: U3.40 (GL_B); also elsewhere on the board
/Mosfet driver/M_L3: U3.35 (GL_C); also elsewhere on the board
/Mosfet driver/SH1_A: R48.1; also elsewhere on the board
/Mosfet driver/SH1_B: R49.1; also elsewhere on the board
/Mosfet driver/SH2_A: R50.1; also elsewhere on the board
/Mosfet driver/SH2_B: R51.1; also elsewhere on the board
GND: C1.1, C8.1, C9.1, C18.2, C19.1, C20.1, C21.1, C23.1, C24.2, C25.1, C33.2, C37.1, C39.1, C40.1, C43.2, C44.2, C45.1, C46.2, C47.1, C48.1, C49.2, C50.1, D4.1 (A), D5.2, R18.2, R20.2, R21.1, R24.1, R25.2, R27.1, R33.1, U2.1 (GND), U3.28 (AGND), U3.39 (SL_B), U3.57 (GND(POWER_PAD)); also elsewhere on the board
unnamed: C18.1, U3.13 (GVDD)
unnamed: C19.2, R19.2, U3.2 (COMP)
unnamed: C20.2, JP3.1, U3.23 (DVDD)
unnamed: C21.2, R19.1
unnamed: C22.1, U3.14 (CP1)
unnamed: C22.2, U3.15 (CP2)
unnamed: C23.2, U3.27 (AVDD)
unnamed: C25.2, L2.2, U3.24 (REF)
unnamed: C27.1, D4.2 (K), L1.1, U3.50 (PH), U3.51 (PH)
unnamed: C27.2, U3.52 (BST_BK)
unnamed: C28.2, U3.48 (BST_A)
unnamed: C29.2, U3.43 (BST_B)
unnamed: C30.2, U3.38 (BST_C)
unnamed: C34.1, R48.2, U3.33 (SN1)
unnamed: C34.2, R49.2, U3.32 (SP1)
unnamed: C36.1, R51.2, U3.30 (SP2)
unnamed: C36.2, R50.2, U3.31 (SN2)
unnamed: C45.2, U3.56 (SS_TR)
unnamed: JP3.2, U3.11 (OC_ADJ)
unnamed: R14.1, R25.1, U3.49 (BIAS)
unnamed: R17.2, R18.1, U3.3 (VSENSE)
unnamed: R20.1, U3.7 (DTC)
unnamed: R21.2, U3.1 (RT_CLK)
VCC: C24.1, L2.1, R14.2, U2.2 (VO); also elsewhere on the board
V_SUPPLY: C1.2, C8.2, C9.2, C37.2, C39.2, C40.2, C43.1, C44.1, C49.1, U3.29 (PVDD1), U3.53 (PVDD2), U3.54 (PVDD2); also elsewhere on the board

Notes on the sheet:
MCU must sense the voltage at each phase
3.3v regulator for the logic
Buck design by TI-Webench: 7V..60V in, 5V/1.4A out (2015-12-30).
C51; 22u,63V,2220 was here, but there was no more space.
100n in parallel would be good here, but there was no space on the board.
6n8 for soft-start recommended.
Should not be needed with proper buck design, but is kept, just in case...
Bridge 2-3 for DRV8301. Bridge 1-2 for DRV8302.
Mount R14 for DRV8301. Mount R25 for DRV8302.

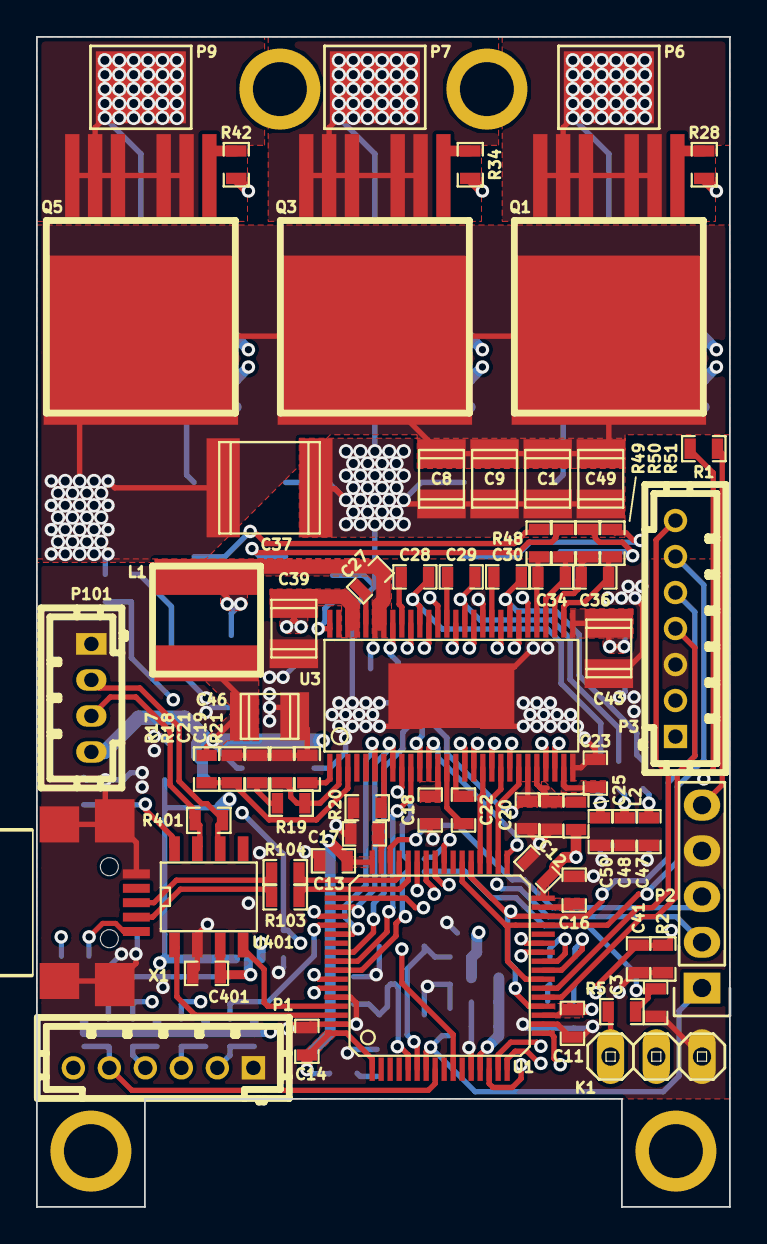
[picture p17: board BLDC_4.kicad_pcb from above]

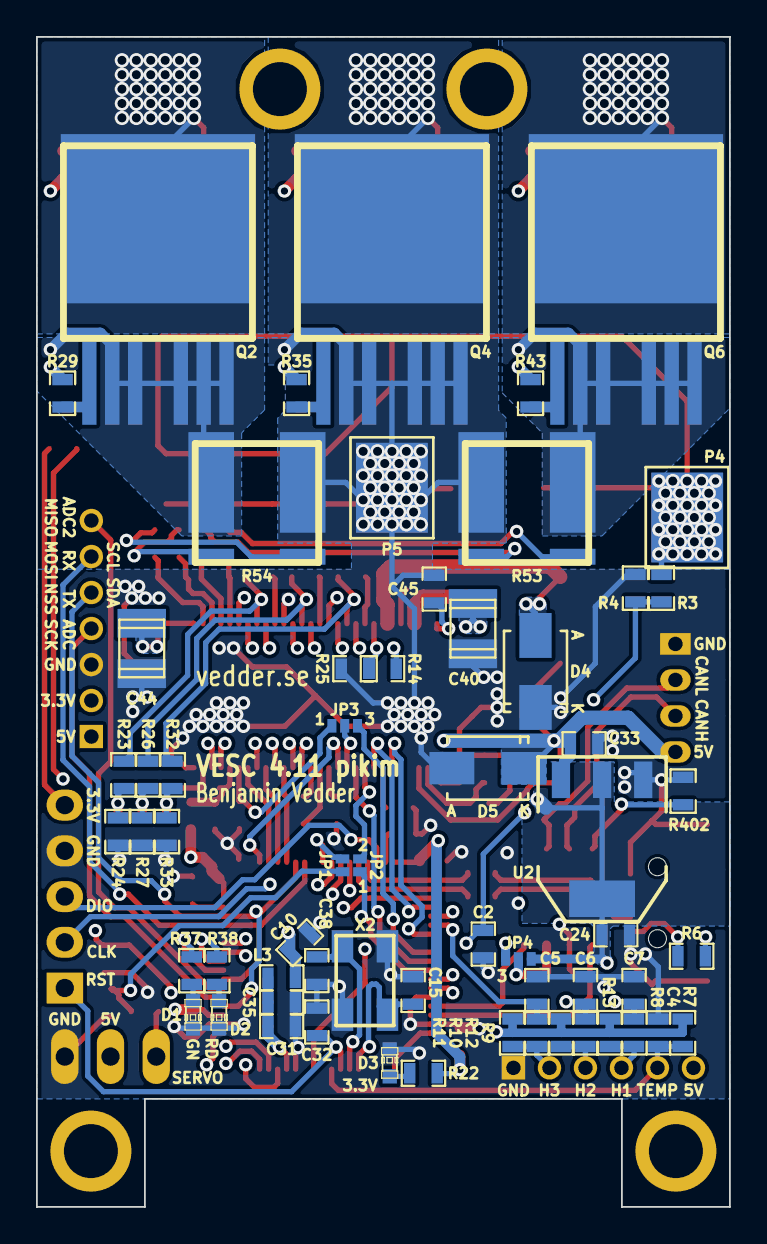
[picture p18: board BLDC_4.kicad_pcb from below]

Board: 4 copper layers, 38.5 x 65.0 mm, 128 parts (60 on the bottom side), 107 nets.
