pikim/bldc-hardware/(commit log)

2016-01-08 Implemented some improvements in schematic, but layout is completely new.
    Changes in schematic:
    - 3.3V or 5V CAN transceiver can be used
    - DRV8301 can also be used and configured via SPI
    - JTAG connector changed
    - Fixed pinning of P1
    - Some additional decoupling and/or filtering of analog signals
    - Improved buck design according TI Webench recommendation
    - Changed some component values
    - maybe others...
    Changes in layout:
    - completely new layout
    - placement of the big components is unchanged
    - CAN connector rotated by 180°
    - kept one layer free as a good GND plane
    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
    [BLDC4.11_BOM.ods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]
2016-01-10 Fixed some errors in v4.11p layout and gerber data. Increased revision to B.
    [BLDC_4-B.Cu.gbl, BLDC_4-B.Mask.gbs, BLDC_4-B.Paste.gbp, BLDC_4-B.SilkS.gbo, BLDC_4-Edge.Cuts.gm1, BLDC_4-F.Cu.gtl, BLDC_4-F.Mask.gts, BLDC_4-F.Paste.gtp]
2016-01-10 Fixed another error in v4.11p layout and gerber data. Increased revision to C.
    [BLDC_4-B.Cu.gbl, BLDC_4-B.Mask.gbs, BLDC_4-B.Paste.gbp, BLDC_4-B.SilkS.gbo, BLDC_4-Edge.Cuts.gm1, BLDC_4-F.Cu.gtl, BLDC_4-F.Mask.gts, BLDC_4-F.Paste.gtp]
